DocTu06/Glidar/code/bluetooth_glidar/flutter_01.png

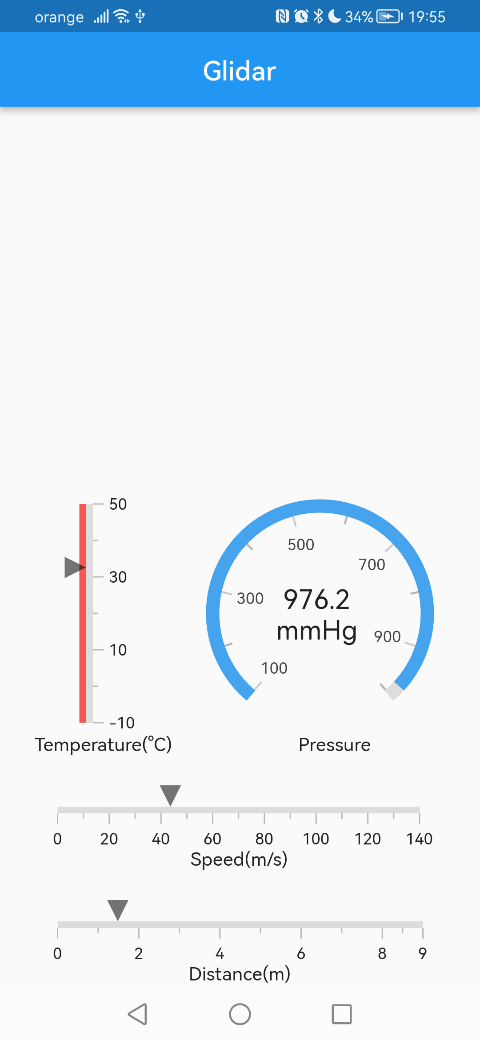
code/bluetooth_glidar/flutter_01.png
