DocTu06/Glidar/Glidar/gliar2023/assets/arrow_down.png

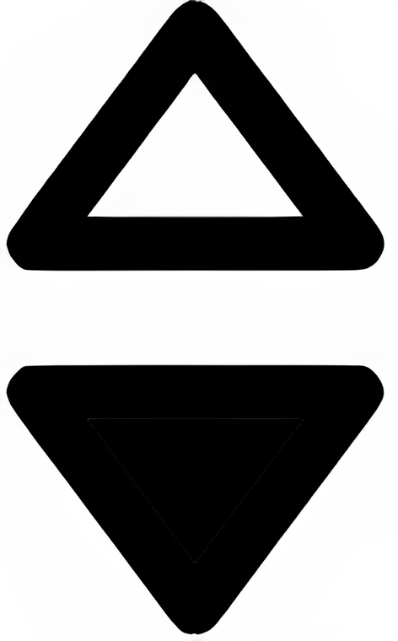
Glidar/gliar2023/assets/arrow_down.png
