DocTu06/Glidar/Glidar/gliar2023/assets/arrow_neutral.png

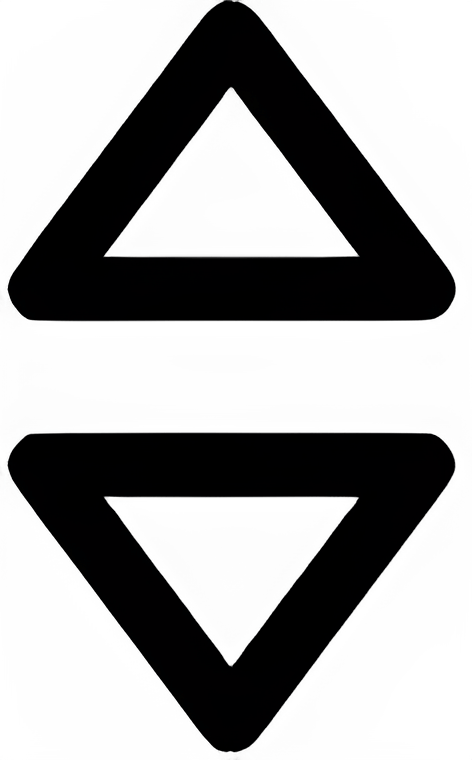
Glidar/gliar2023/assets/arrow_neutral.png
