DocTu06/Glidar/Glidar/gliar2023/assets/arrow_up.png

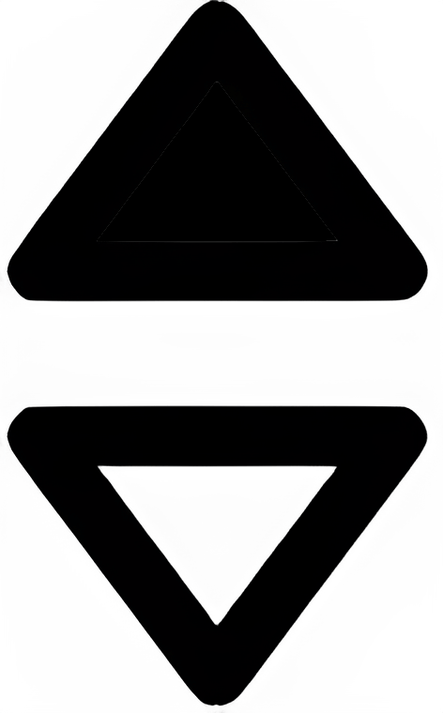
Glidar/gliar2023/assets/arrow_up.png
