DocTu06/Glidar/Glidar/gliar2023/assets/glider_front.png

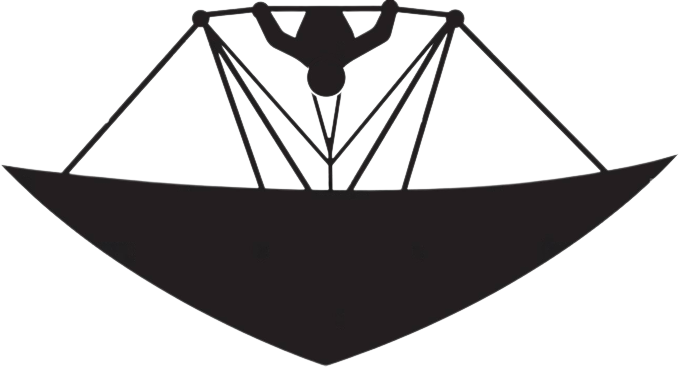
Glidar/gliar2023/assets/glider_front.png
