DocTu06/Glidar/Glidar/gliar2023/assets/glider_top.png

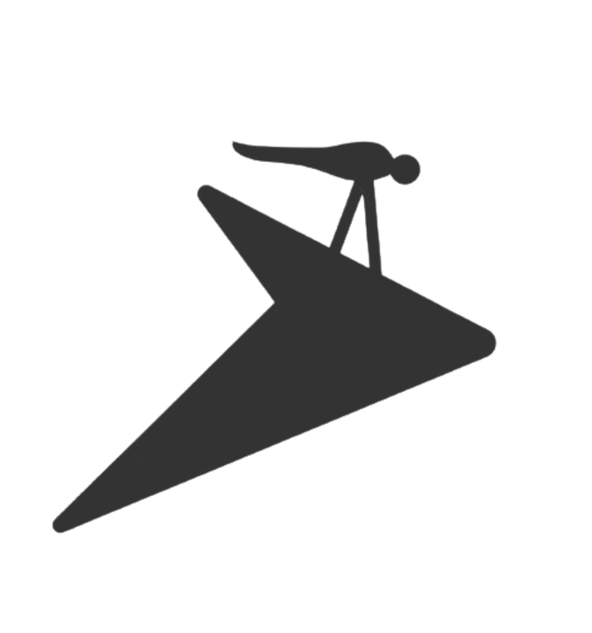
Glidar/gliar2023/assets/glider_top.png
