DocTu06/Glidar/Glidar/gliar2023/assets/file.obj

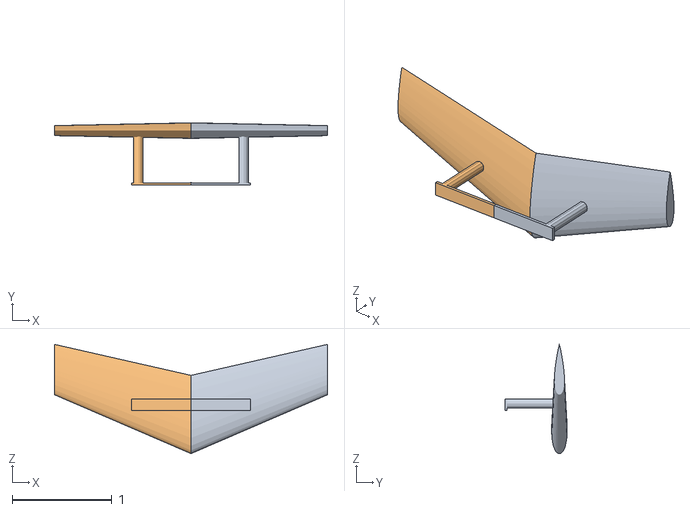
[picture p21: CAD file, 2023-02-25]
Glidar/gliar2023/assets/file.obj
2.73 x 0.624 x 1.09
