DocTu06/Glidar/schema_explodata.pdf

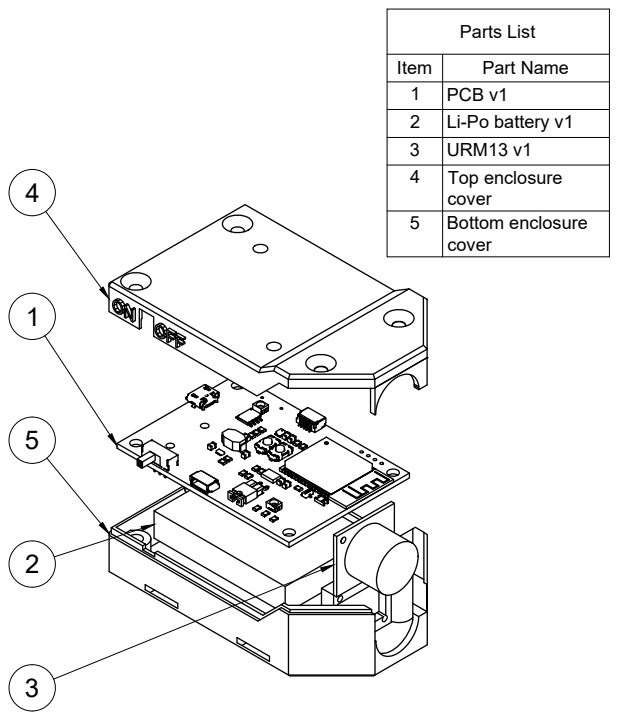
[picture p22: page 1]
Parts List

Item | Part Name
1 | PCB v1
2 | Li-Po battery v1
3 | URM13 v1
4 | Top enclosure cover

5 | Bottom enclosure cover
