DocTu06/Glidar/(commit log)

2023-05-18 Added bluetooth conversion code
    Glidar este un dispozitiv pentru asistarea zborului cu parapanta, care poate furniza următoarele informații utilizatorului: distanța față de sol, viteza, orientarea, temperatura și presiunea, având o durată lungă de viață și fiind compact. Dezvoltarea dispozitivului s-a făcut cu feedback constant din partea parapantiștilor, care au revizuit structura aplicației noastre și au dat feedback-ul pe care l-am folosit pentru a îmbunătăți experiența utilizatorului. Un senzor ultrasonic este folosit pentru a măsura distanța față de sol, deoarece oferă necesarul de distanță maximă detectabilă de 8m și o precizie ridicată de 1cm. Am folosi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
    [file.obj]
2023-05-18 added 3D model
    Glidar este un dispozitiv pentru asistarea zborului cu parapanta, care poate furniza următoarele informații utilizatorului: distanța față de sol, viteza, orientarea, temperatura și presiunea, având o durată lungă de viață și fiind compact. Dezvoltarea dispozitivului s-a făcut cu feedback constant din partea parapantiștilor, care au revizuit structura aplicației noastre și au dat feedback-ul pe care l-am folosit pentru a îmbunătăți experiența utilizatorului. Un senzor ultrasonic este folosit pentru a măsura distanța față de sol, deoarece oferă necesarul de distanță maximă detectabilă de 8m și o precizie ridicată de 1cm. Am folosit un IMU cu 6 axe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
